KonradBorowik/Sunfollower/README.md

# Sunfollower
Project on microcontroller ATMEGA328P. The structure turns a solar panel in the direction of light.

Video: (https://youtu.be/-Tuv1Cj8qro)

* Two servos are used to turn the head.
* LEDs mark states of the machine.
* Enable/disable switch.
* Reset button.
* Key to power-up the system.

Documentation I made for this project is only in Polish but the images speak for themselves. (I know the welding could be better...)
