KonradBorowik/Sunfollower/Sunfollower.pdf

## Karta projektu zaliczeniowego części zadaniowej egzaminu

## Systemy mikroprocesorowe - 2020

### Temat projektu: Zdalny przycisk Sun follower

Imię i nazwisko: Konrad Borowik

Nr albumu: 141023

Kierunek: AiR, grupa: A2,

1. Opis projektu
Na początku myślałem o stworzeniu urządzenia na kształt kontrolera do gier (zdalnego obsługiwania laptopa). Niestety nie potrafiłem nawiązać odpowiedniej komunikacji z komputerem i postanowiłem zmienić koncepcję.

Przedstawiam panel słoneczny podążający za światłem - “Sun follower’’. Układ ma za zadanie ustawiać panel słoneczny w kierunku źródła światła.
2. Hardware
W układzie użyłem:
- mikrokontroler Atmega328P
- koszyczek na mikrokontroler
- przycisk
- dwupołożeniowy switch
- przełącznik ON/OFF z kluczykiem
- 5 diod LED
- kwarc 16 MHz
- 2 kondensatory 22 pF
- fotorezystory 5k-10kohm
- 5 rezystorów 270 ohm
- 1 rezystor 10 kohm
- 4 rezystory 220 ohm
- 2 serwomechanizmy S90 micro
- powerbank
- płytka arduino uno
- panel słoneczny
- przewody
- klocki LEGO
- płytka uniwersalna

Systemy Mikroprocesorowe – kierunek AiR na WI - Politechnika Poznańska 2020

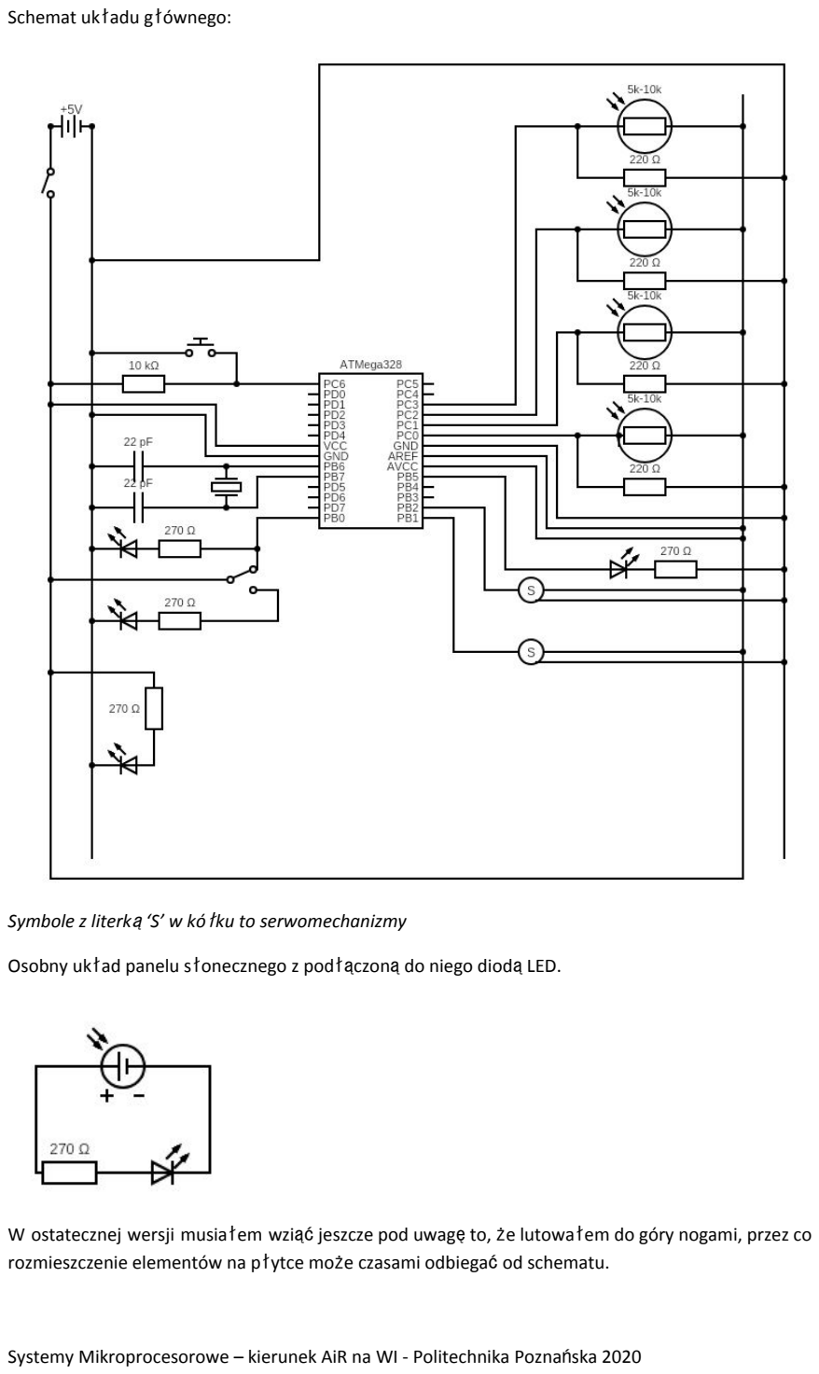
[picture p1: page 2]

Schemat układu głównego:

Symbole z literką ‘S’ w kółku to serwomechanizmy

Osobny układ panelu słonecznego z podłączoną do niego diodą LED.

W ostatecznej wersji musiałem wziąć jeszcze pod uwagę to, że lutowałem do góry nogami, przez co rozmieszczenie elementów na płytce może czasami odbiegać od schematu.

3. Software
Schemat blokowy działania oprogramowania:

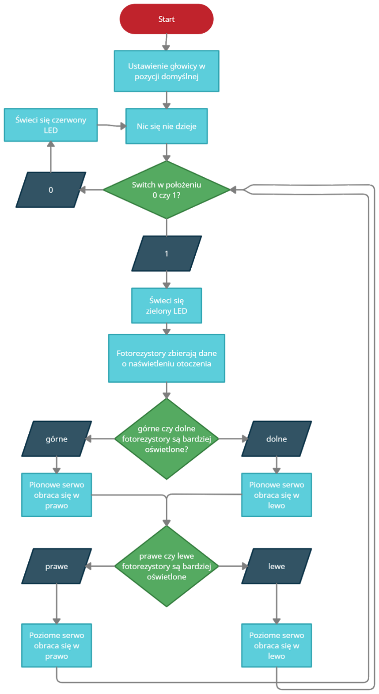
[picture p2: figure]

Najważniejsze funkcje programu to przetworzenie danych o naświetleniu fotorezystorów, porównaniu zebranych informacji ze sobą, stwierdzenie kierunku ruchu i przekazanie odpowiedniej informacji do odpowiedniego serwomechanizmu.
Np.: górne fotorezystory otrzymują więcej światła, wtedy, poprzez porównanie z oporem dolnych fotorezystorów, program obiera kierunek: ”góra” i serwomechanizm pionowe obraca się w prawo. Następnie porównywane są wartości lewych i prawych fotorezystorów. Gdy lewe są lepiej oświetlone, wtedy poziome serwomechanizm obraca się w lewo. Aby głowica sun followera przesuwała się płynnie, tego typu porównanie wykonywane jest kilkanaście razy na sekundę.

W programie wykorzystałem bibliotekę <Servo.h>.

Mikrokontroler zaprogramowałem w środowisku Arduino IDE i w trakcie testowania wgrywałem na niego próbne programy za pomocą Arduino UNO.

Mikrokontroler zakupiłem z fabrycznie wgranym bootloaderem, więc był od razu gotowy do użytku.

4. Proces montażu i programowania systemu
Niestety nie posiadam zdjęć z wczesnych faz projektu, dlatego zamieściłem zdjęcia głównych elementów dla danej fazy.

Na początku, w ramach sprawdzenia, czy układ w ogóle zadziała, postanowiłem wykorzystać Arduino Uno, fotorezystory oraz serwomechanizmy i podłączyłem wszystko na płytkach prototypowych.

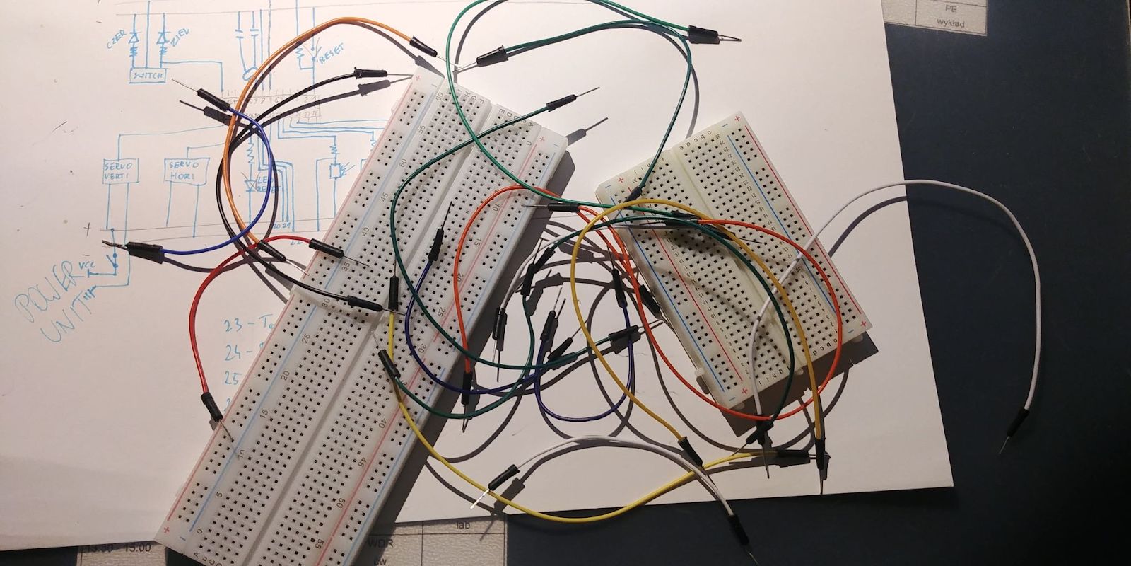
[picture p3: figure]
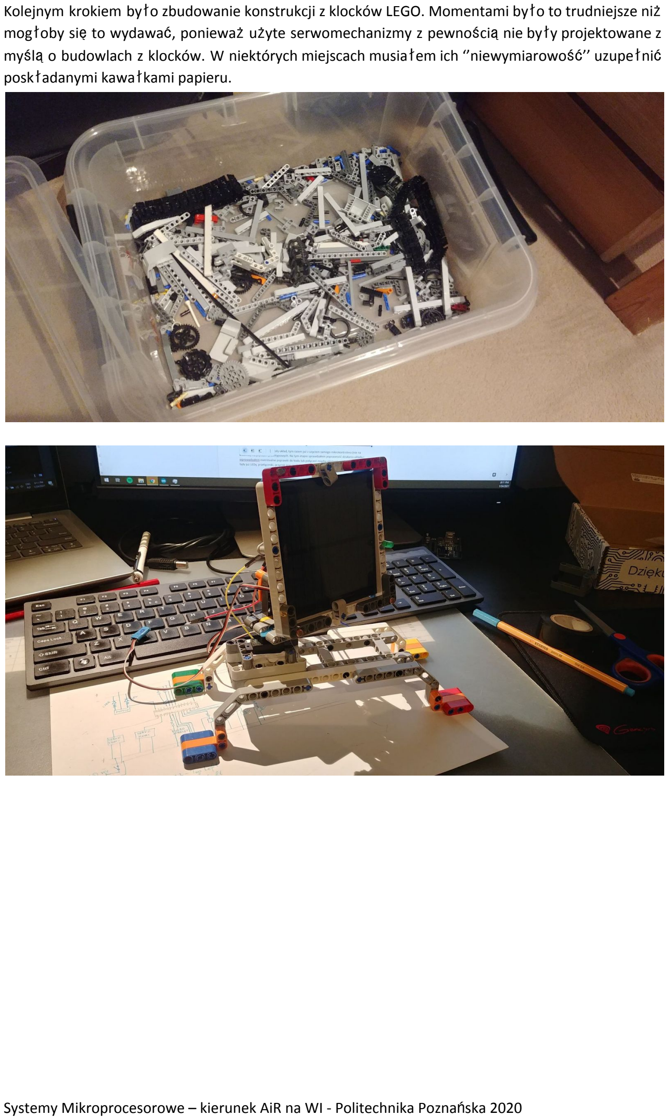
[picture p4: page 5]

Kolejnym krokiem było zbudowanie konstrukcji z klocków LEGO. Momentami było to trudniejsze niż mogłoby się to wydawać, ponieważ użyte serwomechanizmy z pewnością nie były projektowane z myślą o budowlach z klocków. W niektórych miejscach musiałem ich ‘’niewymiarowość’’ uzupełnić poskładanymi kawałkami papieru.

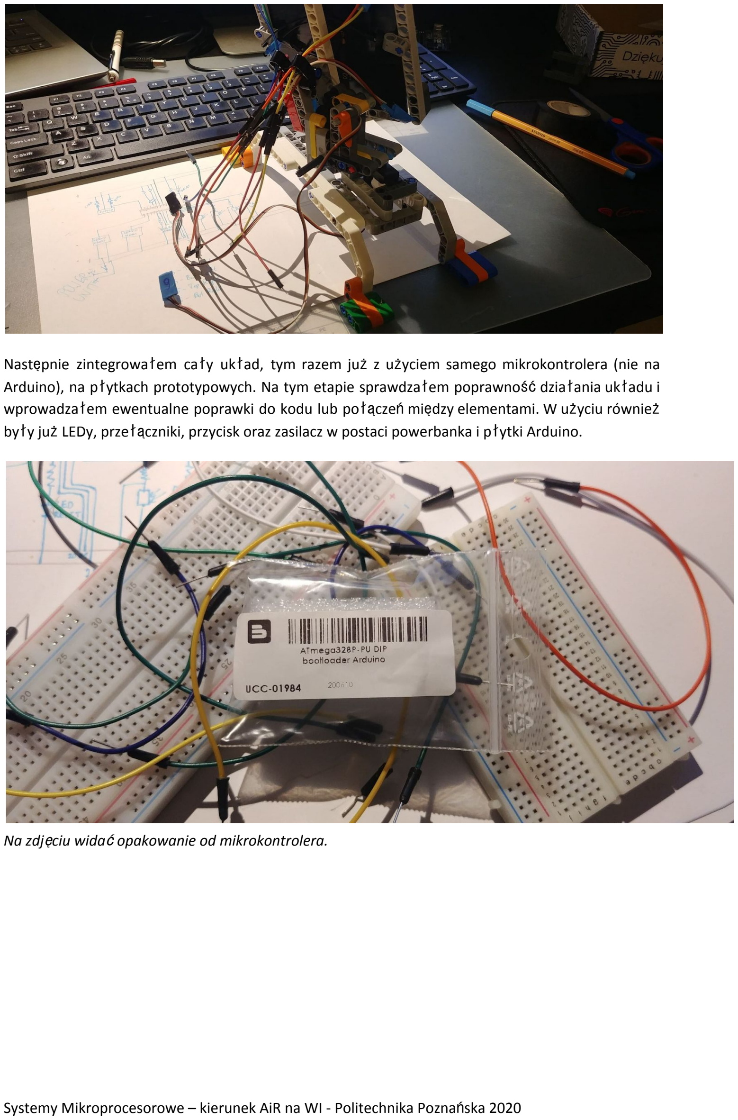
[picture p5: page 6]

Następnie zintegrowałem cały układ, tym razem już z użyciem samego mikrokontrolera (nie na Arduino), na płytkach prototypowych. Na tym etapie sprawdzałem poprawność działania układu i wprowadzałem ewentualne poprawki do kodu lub połączeń między elementami. W użyciu również były już LEDy, przełączniki, przycisk oraz zasilacz w postaci powerbanka i płytki Arduino.

Na zdjęciu widać opakowanie od mikrokontrolera.

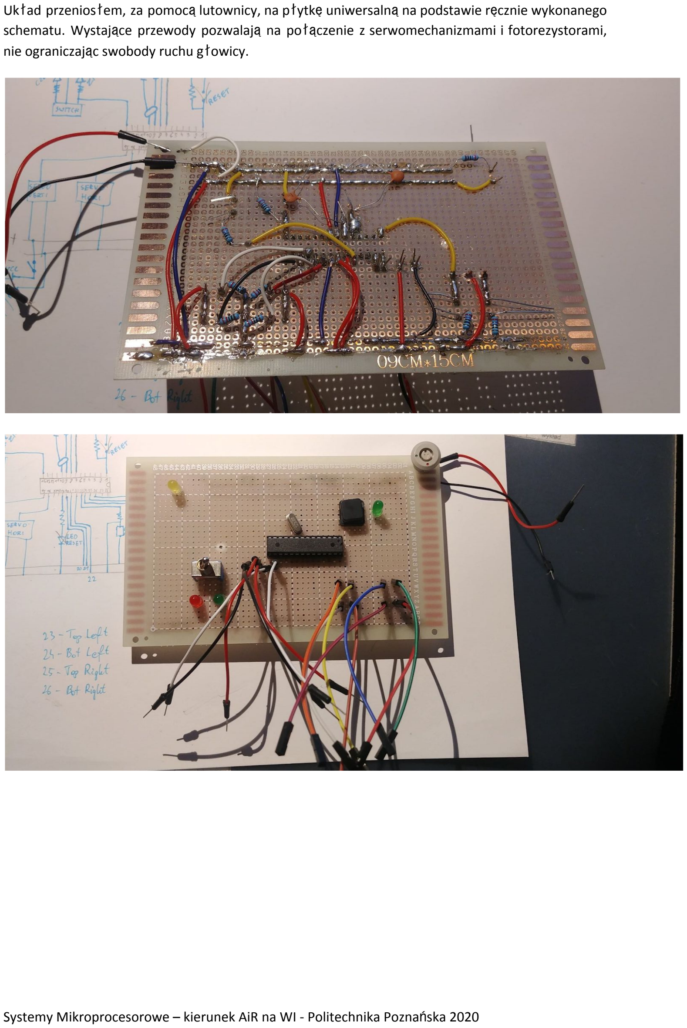
[picture p6: page 7]

Układ przeniosłem, za pomocą lutownicy, na płytkę uniwersalną na podstawie ręcznie wykonanego schematu. Wystające przewody pozwalają na połączenie z serwomechanizmami i fotorezystorami, nie ograniczając swobody ruchu głowicy.

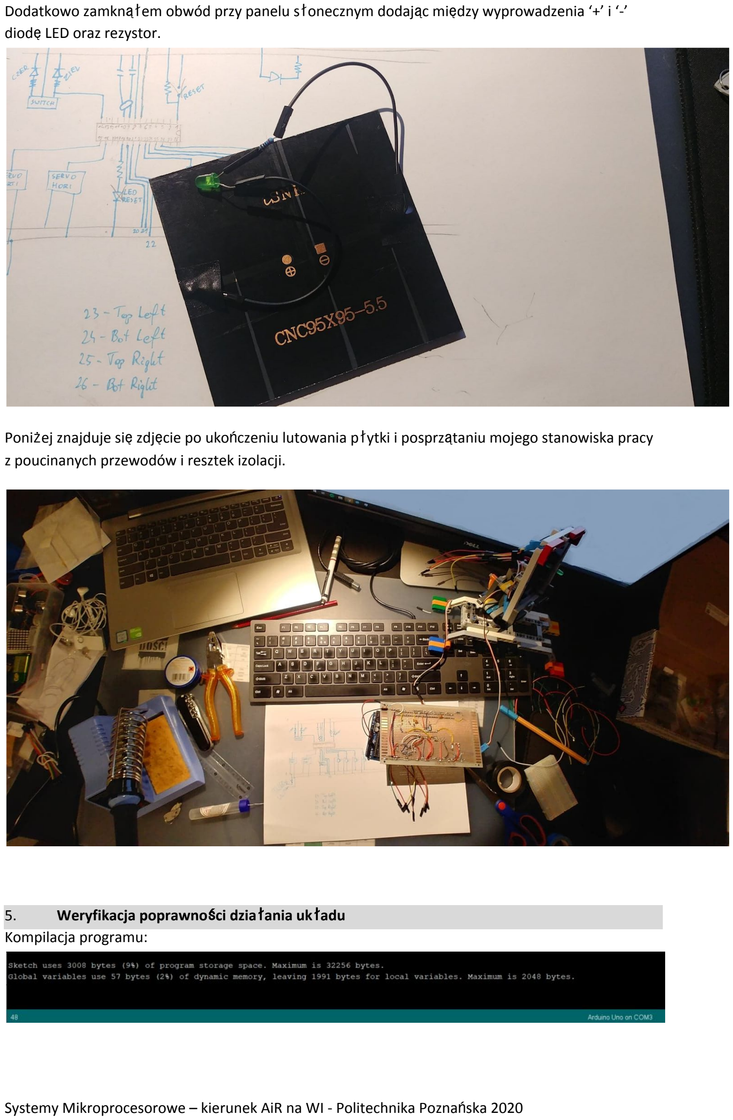
[picture p7: page 8]

Dodatkowo zamknąłem obwód przy panelu słonecznym dodając między wyprowadzenia ‘+’ i ‘-’ diodę LED oraz rezystor.

Poniżej znajduje się zdjęcie po ukończeniu lutowania płytki i posprzątaniu mojego stanowiska pracy z poucinanych przewodów i resztek izolacji.

5. Weryfikacja poprawności działania układu Kompilacja programu:

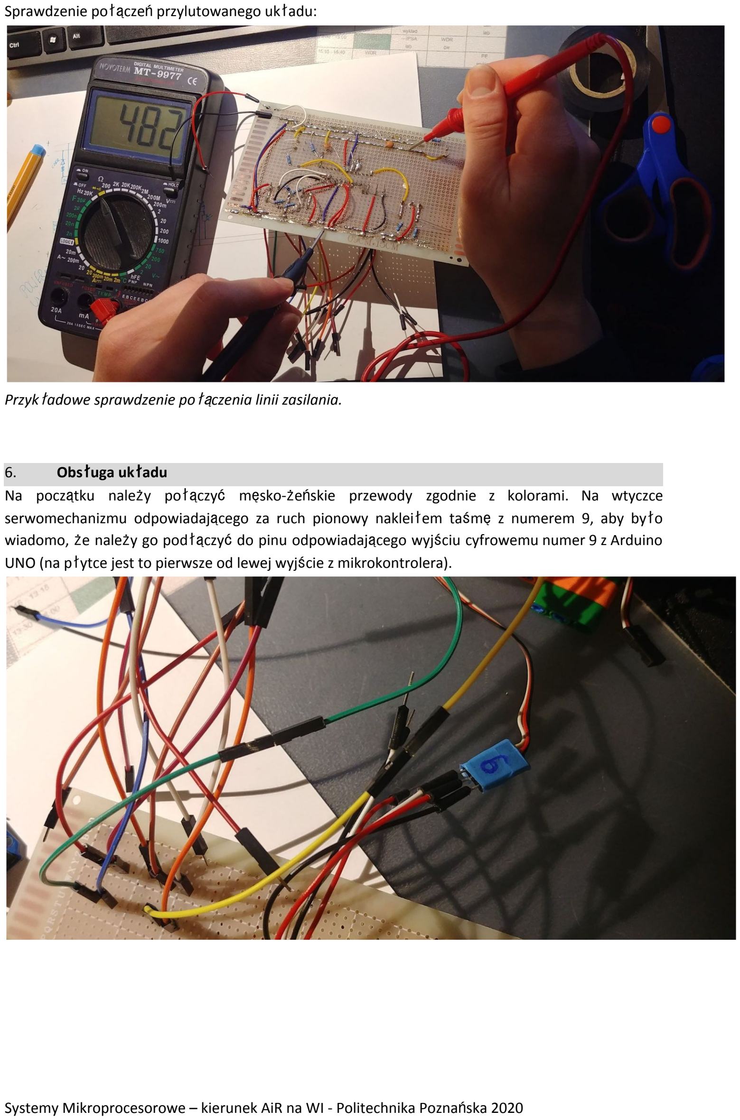
[picture p8: page 9]

Sprawdzenie połączeń przylutowanego układu:

Przykładowe sprawdzenie połączenia linii zasilania.

6. Obsługa układu
Na początku należy połączyć męsko-żeńskie przewody zgodnie z kolorami. Na wtyczce serwomechanizmu odpowiadającego za ruch pionowy nakleiłem taśmę z numerem 9, aby było wiadomo, że należy go podłączyć do pinu odpowiadającego wyjściu cyfrowemu numer 9 z Arduino UNO (na płytce jest to pierwsze od lewej wyjście z mikrokontrolera).

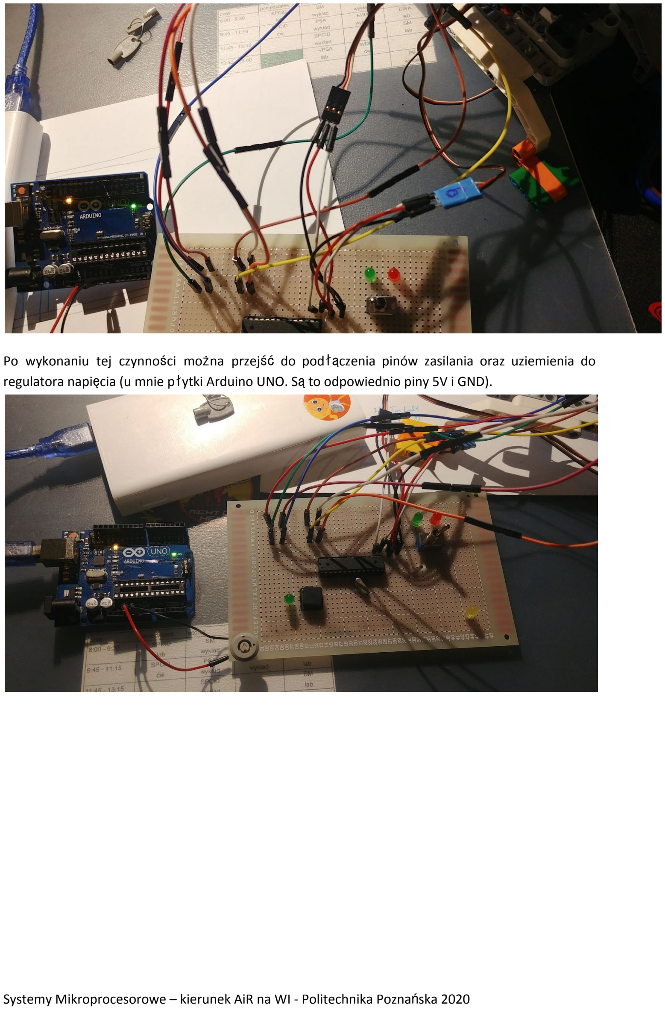
[picture p9: page 10]

Po wykonaniu tej czynności można przejść do podłączenia pinów zasilania oraz uziemienia do regulatora napięcia (u mnie płytki Arduino UNO. Są to odpowiednio piny 5V i GND).

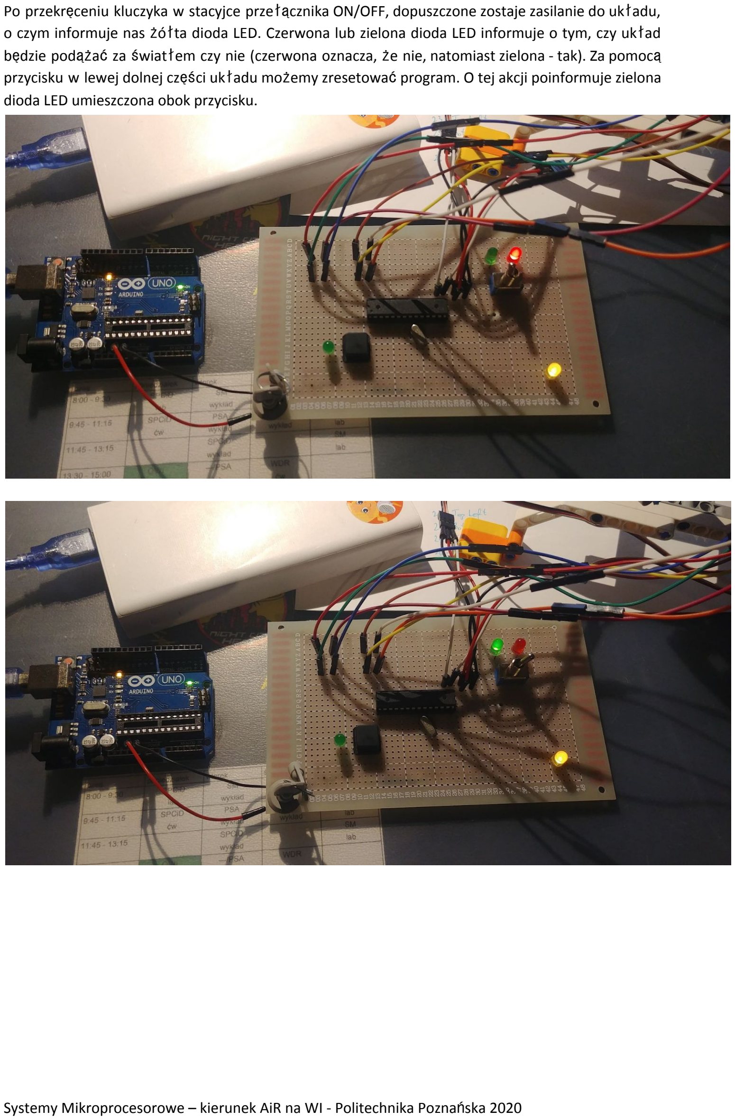
[picture p10: page 11]

Po przekręceniu kluczyka w stacyjce przełącznika ON/OFF, dopuszczone zostaje zasilanie do układu, o czym informuje nas żółta dioda LED. Czerwona lub zielona dioda LED informuje o tym, czy układ będzie podążać za światłem czy nie (czerwona oznacza, że nie, natomiast zielona - tak). Za pomocą przycisku w lewej dolnej części układu możemy zresetować program. O tej akcji poinformuje zielona dioda LED umieszczona obok przycisku.

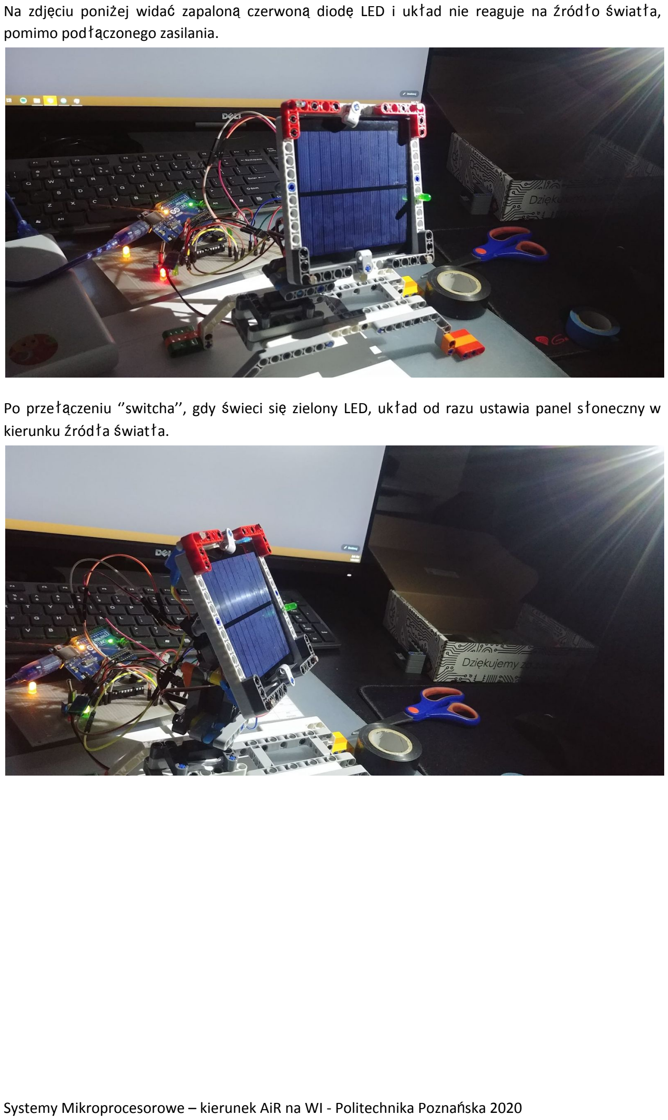
[picture p11: page 12]

Na zdjęciu poniżej widać zapaloną czerwoną diodę LED i układ nie reaguje na źródło światła, pomimo podłączonego zasilania.

Po przełączeniu ‘’switcha’’, gdy świeci się zielony LED, układ od razu ustawia panel słoneczny w kierunku źródła światła.

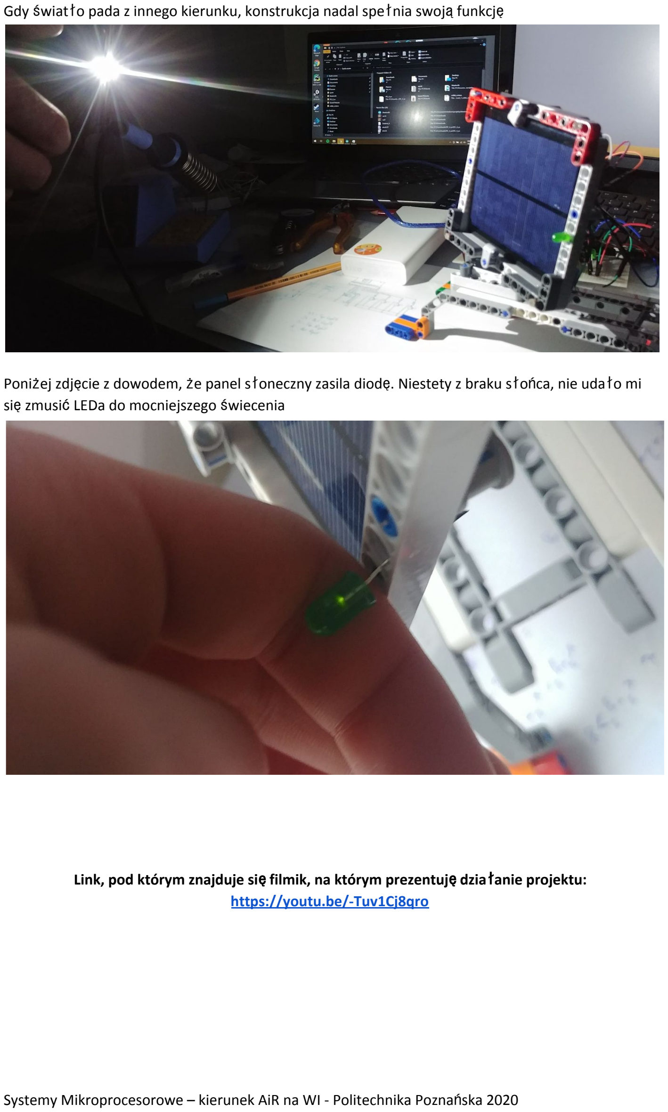
[picture p12: page 13]

Gdy światło pada z innego kierunku, konstrukcja nadal spełnia swoją funkcję

Poniżej zdjęcie z dowodem, że panel słoneczny zasila diodę. Niestety z braku słońca, nie udało mi się zmusić LEDa do mocniejszego świecenia

Link, pod którym znajduje się filmik, na którym prezentuję działanie projektu: https://youtu.be/-Tuv1Cj8qro

Aby łatwiej było udokumentować działanie konstrukcji, postanowiłem dopiero na koniec schować jednostkę zasilającą i przymocować płytkę z układem do pudełka. Dzięki zastosowanym przewodom męsko-żeńskim, konstrukcję z panelem słonecznym można przenieść dalej od płytki. W
takim | wypadku | należy | dołożyć | więcej | wyżej | wymienionych | przewodów.

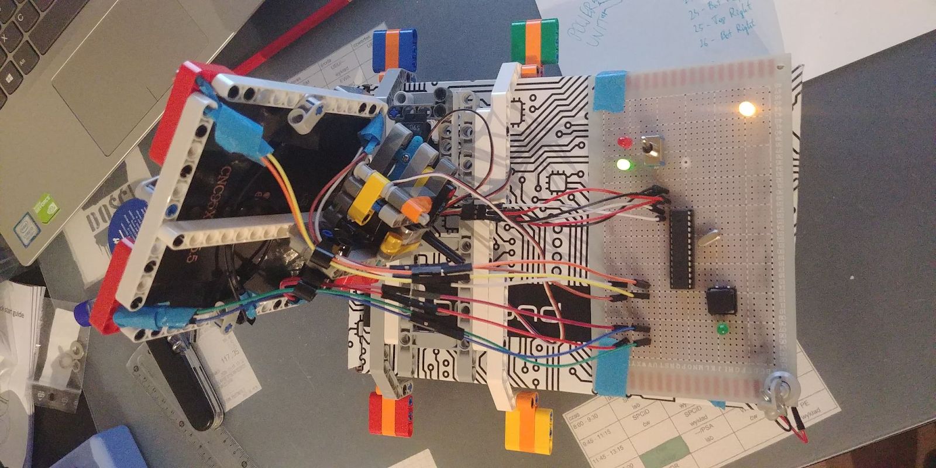
[picture p13: figure]

7. Literatura
- https://www.instructables.com/Arduino-Solar-Tracker-Single-or-Dual-Axis/ - inspiracja do wykonania tego projektu
- Arduino.cc
- https://stackoverflow.com/
- https://www.digikey.com/en/maker/projects/build-your-own-arduino-breadboard/f243b09293ae4e3189bda47a821bb97a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 stQoXCE4n2tOFvk9m4 (https://www.digikey.com/en/maker/projects/build-your-own-arduino-breadboard/f243b09293ae4e3189bda47a821bb97a)
- https://www.youtube.com/channel/UC67BBzDdX3jMRy7TrhgpJGQ - pomoc w lutowaniu
- https://www.circuit-diagram.org/
- https://app.creately.com/diagram/ikFbXHQbcc6/edit
